thijsjek/Nixie-clock/README.md

# Nixie-clock
Raspberry pi zero based nixie tube clock
https://thijskanters.wordpress.com for detailed information and PCB design files
