thijsjek/Nixie-clock/(list of files, cad)

Other CAD files:
Case/Top v1.0 final.skp
Case/bottom v1.3.skp
