thijsjek/Nixie-clock/PCB/v2.x/Tube board v2.1.brd

## EAGLE design PCB/v2.x/Tube board v2.1.brd (2016-04-20)

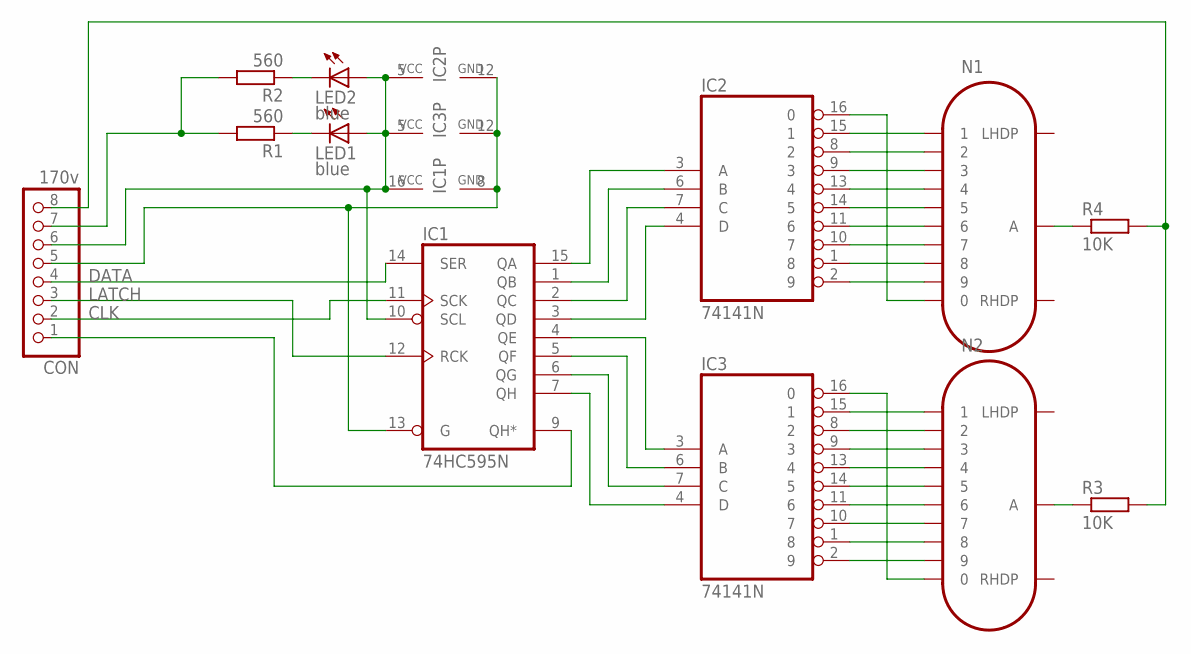
[picture p1: schematic Tube board v2.1.sch]

Parts:
CON: 170v; 1X08
IC1: 74HC595N; DIL16
IC2, IC3: 74141N; DIL16
LED1, LED2: blue; LED3MM
N1, N2: IN-14
R1, R2: 560; 0204/7
R3, R4: 10K; 0204/7

Connections:
170V: CON.8, R3.2, R4.2
CLK: CON.2, IC1.11 (SCK)
DATA: CON.4, IC1.14 (SER)
GND: CON.5, IC1.8 (GND), IC1.13 (G), IC2.12 (GND), IC3.12 (GND)
LATCH: CON.3, IC1.12 (RCK)
unnamed: LED1.K (C), R1.1
unnamed: CON.7, R1.2, R2.2
unnamed: LED2.K (C), R2.1
unnamed: IC1.15 (QA), IC2.3 (A)
unnamed: IC1.1 (QB), IC2.6 (B)
unnamed: IC1.2 (QC), IC2.7 (C)
unnamed: IC1.3 (QD), IC2.4 (D)
unnamed: IC1.7 (QH), IC3.4 (D)
unnamed: IC1.6 (QG), IC3.7 (C)
unnamed: IC1.5 (QF), IC3.6 (B)
unnamed: IC1.4 (QE), IC3.3 (A)
unnamed: CON.1, IC1.9 (QH*)
unnamed: IC2.16 (0), N1.0
unnamed: IC2.15 (1), N1.1
unnamed: IC2.8 (2), N1.2
unnamed: IC2.9 (3), N1.3
unnamed: IC2.13 (4), N1.4
unnamed: IC2.14 (5), N1.5
unnamed: IC2.11 (6), N1.6
unnamed: IC2.10 (7), N1.7
unnamed: IC2.1 (8), N1.8
unnamed: IC2.2 (9), N1.9
unnamed: IC3.15 (1), N2.1
unnamed: IC3.8 (2), N2.2
unnamed: IC3.9 (3), N2.3
unnamed: IC3.13 (4), N2.4
unnamed: IC3.14 (5), N2.5
unnamed: IC3.11 (6), N2.6
unnamed: IC3.10 (7), N2.7
unnamed: IC3.1 (8), N2.8
unnamed: IC3.2 (9), N2.9
unnamed: IC3.16 (0), N2.0
unnamed: N2.A, R3.1
unnamed: N1.A, R4.1
VCC: CON.6, IC1.10 (SCL), IC1.16 (VCC), IC2.5 (VCC), IC3.5 (VCC), LED1.A, LED2.A

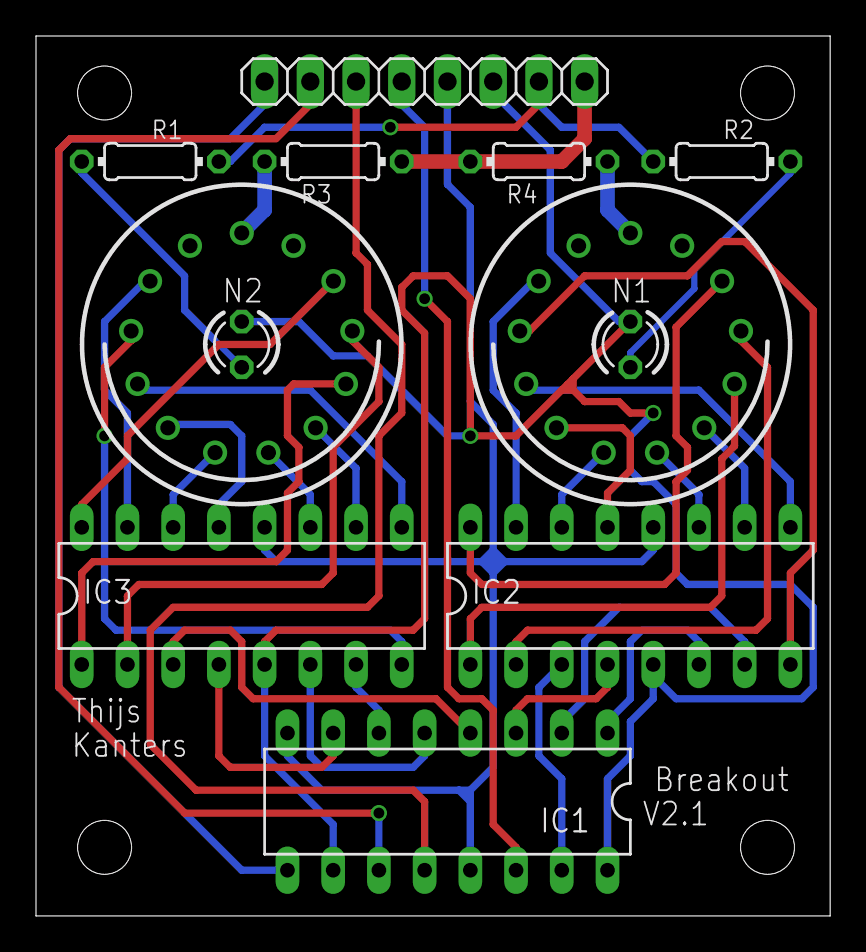
[picture p2: board Tube board v2.1.brd from above]

Board: 2 copper layers, 44.1 x 48.9 mm, 12 parts (0 on the bottom side), 40 nets.
