thijsjek/Nixie-clock/PCB/v2.x/Main board v2.0.brd

## EAGLE design PCB/v2.x/Main board v2.0.brd (2016-04-20)

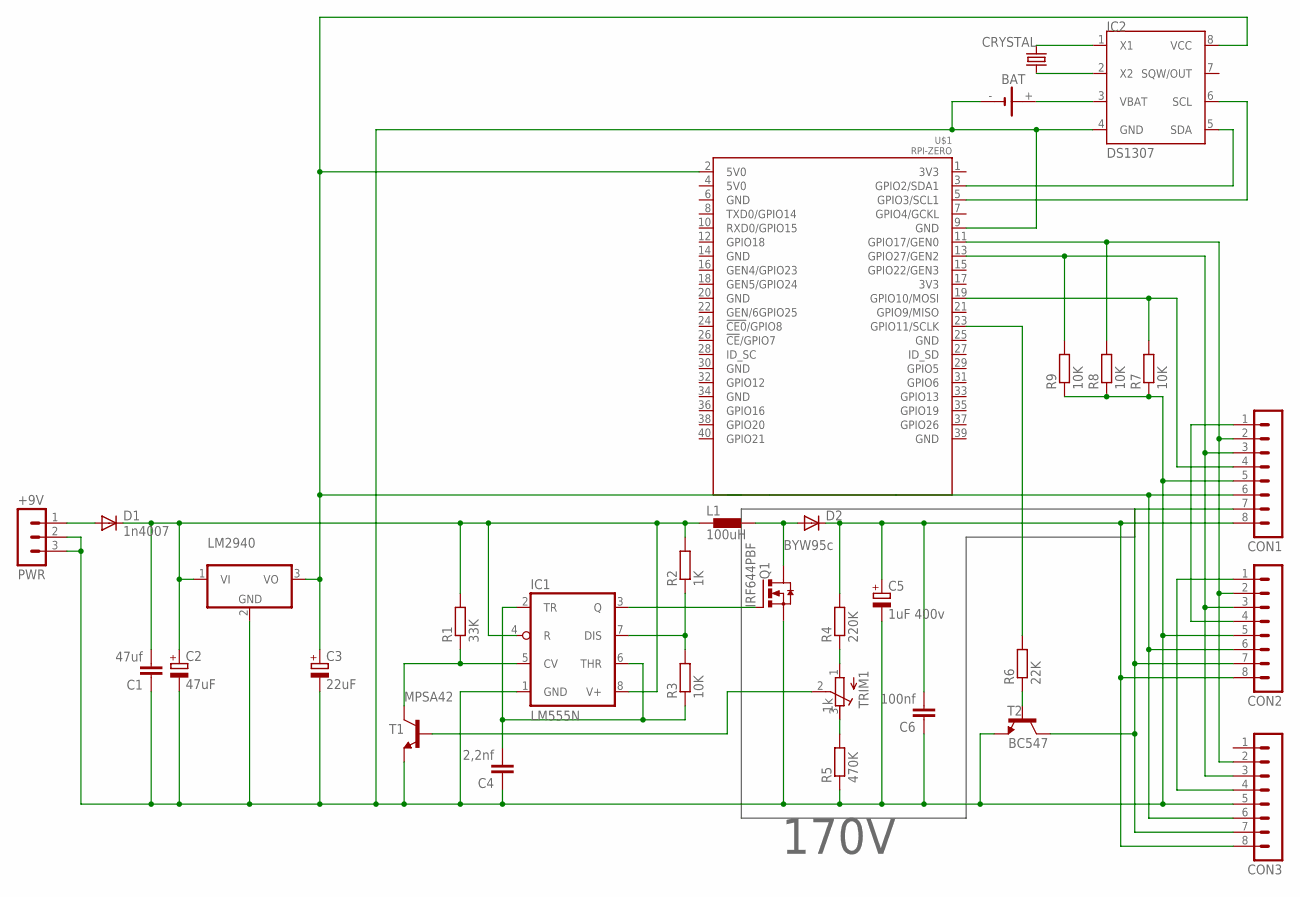
[picture p3: schematic Main board v2.0.sch]

Parts:
BAT: CH291-1220LF
C1: 47uf; C025-025X050
C2: 47uF; E5-8,5
C3: 22uF; E2,5-4R
C4: 2,2nf; C5B2.5
C5: 1uF 400v; E2,5-6
C6: 100nf; C075-032X103
CON1, CON2, CON3: MA08-1
CRYSTAL: crystal; TC26H
D1: 1n4007; DO41-10
D2: BYW95c; SOD64-10
IC1: LM555N; DIL08
IC2: DS1307; SOIC-8
L1: 100uH; DR1030
LM2940: 7824T; TO220V
PWR: +9V; MA03-1
Q1: IRF644PBF; TO262-H
R1: 33K; 0207/10
R2: 1K; 0207/10
R3, R7, R8, R9: 10K; 0207/10
R4: 220K; 0207/10
R5: 470K; 0207/10
R6: 22K; 0207/10
T1: MPSA42; TO92-EBC
T2: BC547; TO92-CBE
TRIM1: 1k; RTRIM64W
U$1: RPI-ZERO; RASPBERRYPI_BASTELSTUBE_V13_RASPI_BOARD_B+_FULL

Connections:
5V0: C3.+, CON1.6, CON2.6, CON3.6, IC2.8 (VCC), LM2940.3 (VO), U$1.2 (5V0)
170V: C5.+, C6.2, CON1.8, CON2.8, CON3.8, D2.C, R4.2
CLK: CON1.2, CON2.2, CON3.2, R8.2, U$1.11 (GPIO17/GEN0)
DATA: CON1.4, R7.2, U$1.19 (GPIO10/MOSI)
GND@1: BAT.-, C1.1, C2.-, C3.-, C4.1, C5.-, C6.1, CON1.5, CON2.5, CON3.5, IC1.1 (GND), IC2.4 (GND), LM2940.2 (GND), PWR.2, PWR.3, Q1.3 (S), R5.1, R7.1, R8.1, R9.1, T1.E, T2.E, U$1.9 (GND)
LATCH: CON1.3, CON2.3, CON3.3, R9.2, U$1.13 (GPIO27/GEN2)
LED: CON1.7, CON2.7, CON3.7, T2.C
LEDDRIVER: R6.2, U$1.23 (GPIO11/SCLK)
unnamed: CON1.1, CON2.4
unnamed: CON2.1, CON3.4
unnamed: R4.1, TRIM1.1 (A)
unnamed: R6.1, T2.B
unnamed: IC2.6 (SCL), U$1.5 (GPIO3/SCL1)
unnamed: IC2.5 (SDA), U$1.3 (GPIO2/SDA1)
unnamed: CRYSTAL.1, IC2.2 (X2)
unnamed: CRYSTAL.2, IC2.1 (X1)
unnamed: D1.A, PWR.1
unnamed: IC1.3 (Q), Q1.1 (G)
unnamed: IC1.7 (DIS), R2.1, R3.2
unnamed: IC1.5 (CV), R1.1, T1.C
unnamed: C4.2, IC1.2 (TR), IC1.6 (THR), R3.1
unnamed: D2.A, L1.2, Q1.2 (D)
unnamed: T1.B, TRIM1.2 (S)
unnamed: R5.2, TRIM1.3 (E)
V+: C1.2, C2.+, D1.C, IC1.4 (R), IC1.8 (V+), L1.1, LM2940.1 (VI), R1.2, R2.2
VBAT: BAT.+, IC2.3 (VBAT)

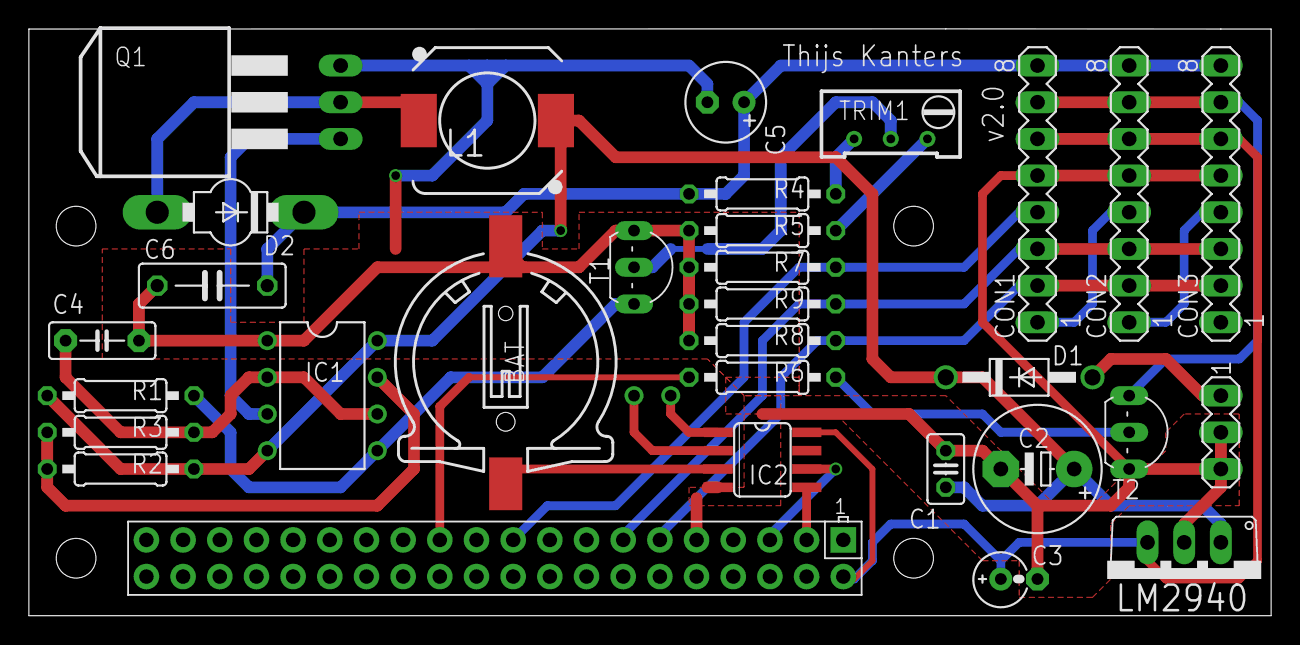
[picture p4: board Main board v2.0.brd from above]

Board: 2 copper layers, 86.0 x 40.6 mm, 32 parts (1 on the bottom side), 26 nets.
